tabahi/eBike-Controller/pictures/IMG_20250413_105654676.jpg

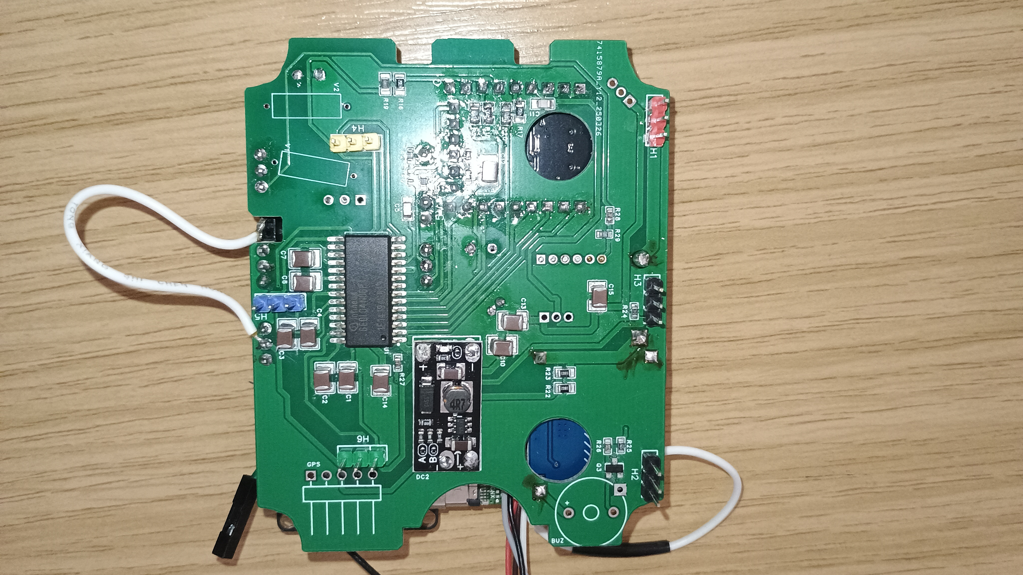
pictures/IMG_20250413_105654676.jpg
