tabahi/eBike-Controller/pictures/IMG_20250413_105704691.jpg

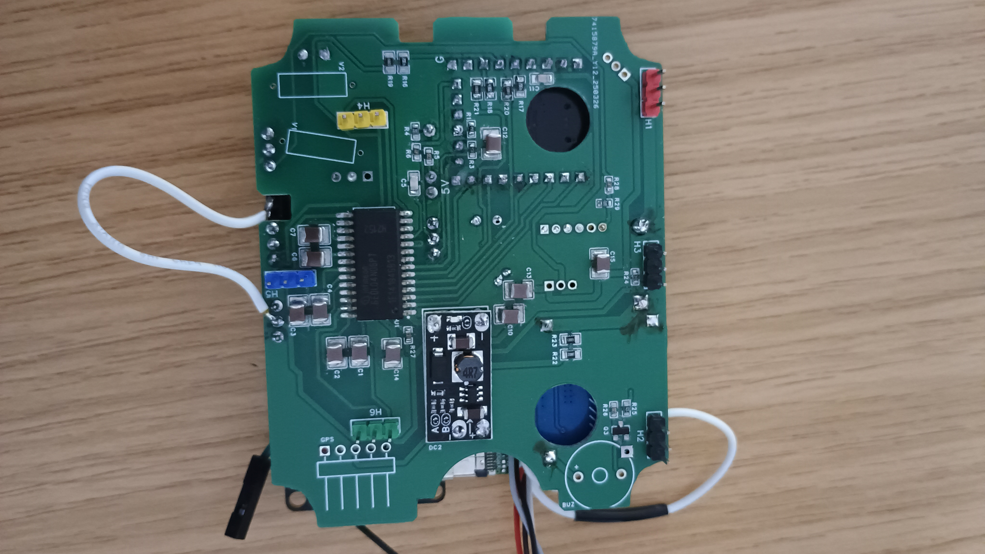
pictures/IMG_20250413_105704691.jpg
