tabahi/eBike-Controller/pictures/IMG_20250413_105737001_HDR.jpg

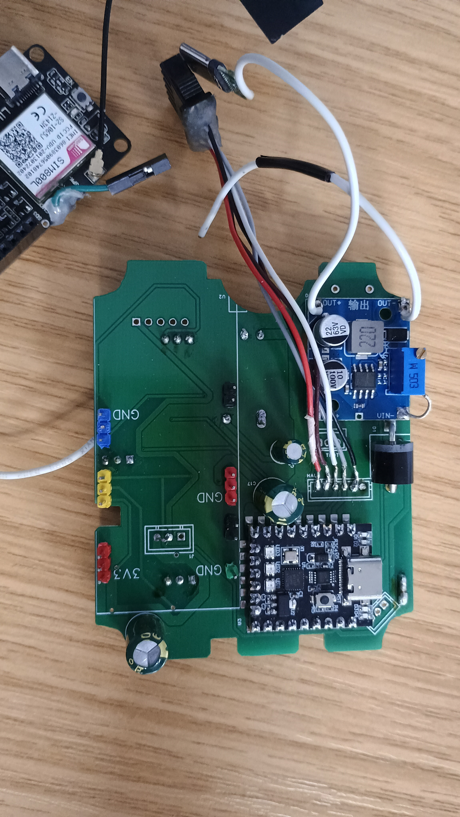
pictures/IMG_20250413_105737001_HDR.jpg
