tabahi/eBike-Controller/pictures/IMG_20250413_105749587.jpg

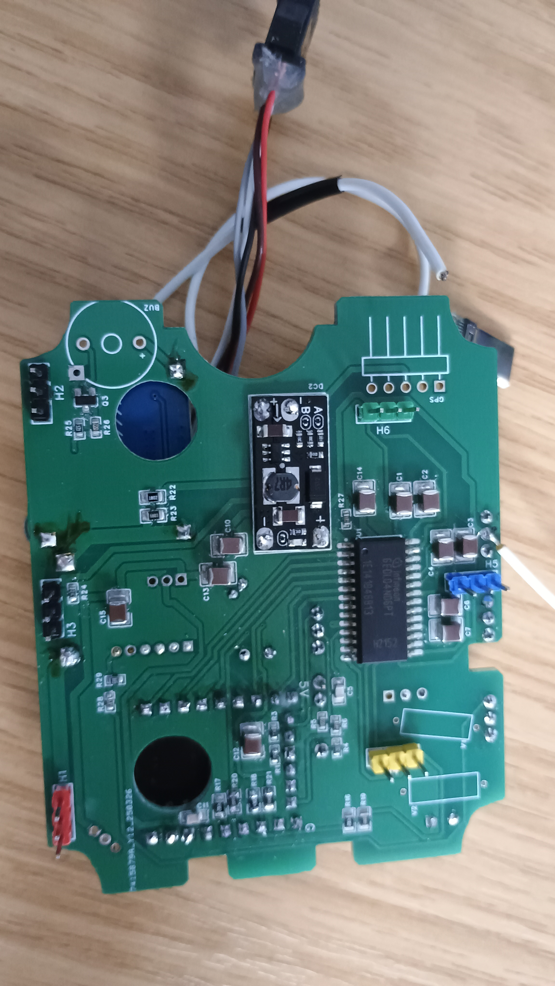
pictures/IMG_20250413_105749587.jpg
