tabahi/eBike-Controller/pictures/IMG_20250413_105753850.jpg

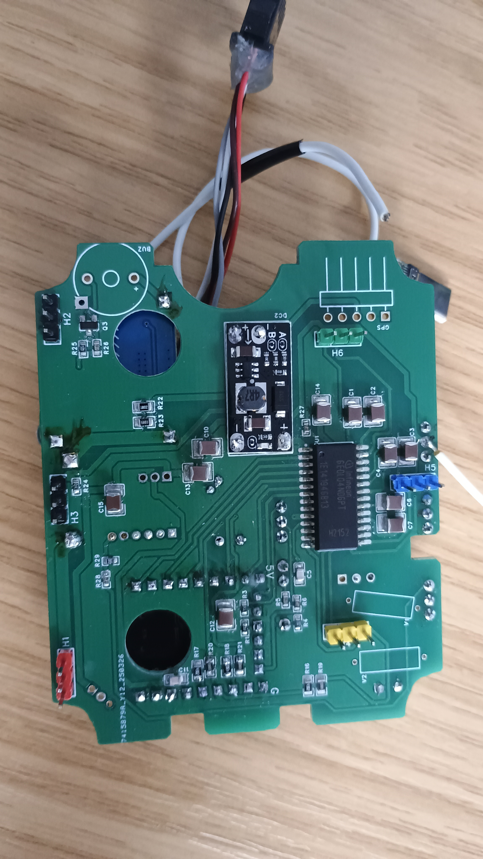
pictures/IMG_20250413_105753850.jpg
