tabahi/eBike-Controller/pictures/IMG_20250518_181155994_HDR.jpg

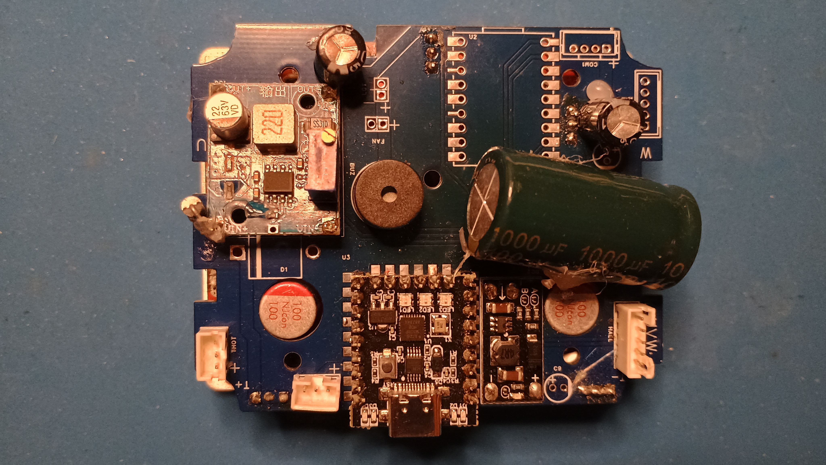
pictures/IMG_20250518_181155994_HDR.jpg
