tabahi/eBike-Controller/pictures/IMG_20250518_181207546_HDR.jpg

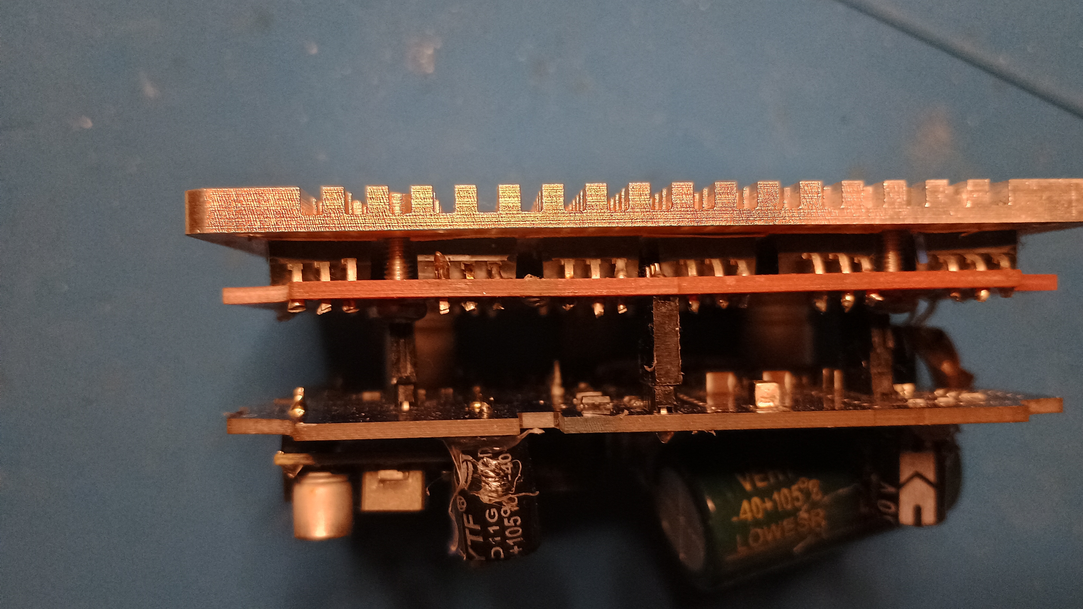
pictures/IMG_20250518_181207546_HDR.jpg
