tabahi/eBike-Controller/PCB_files/Schematic_mosfets_drive_uC_2025-11-24.pdf

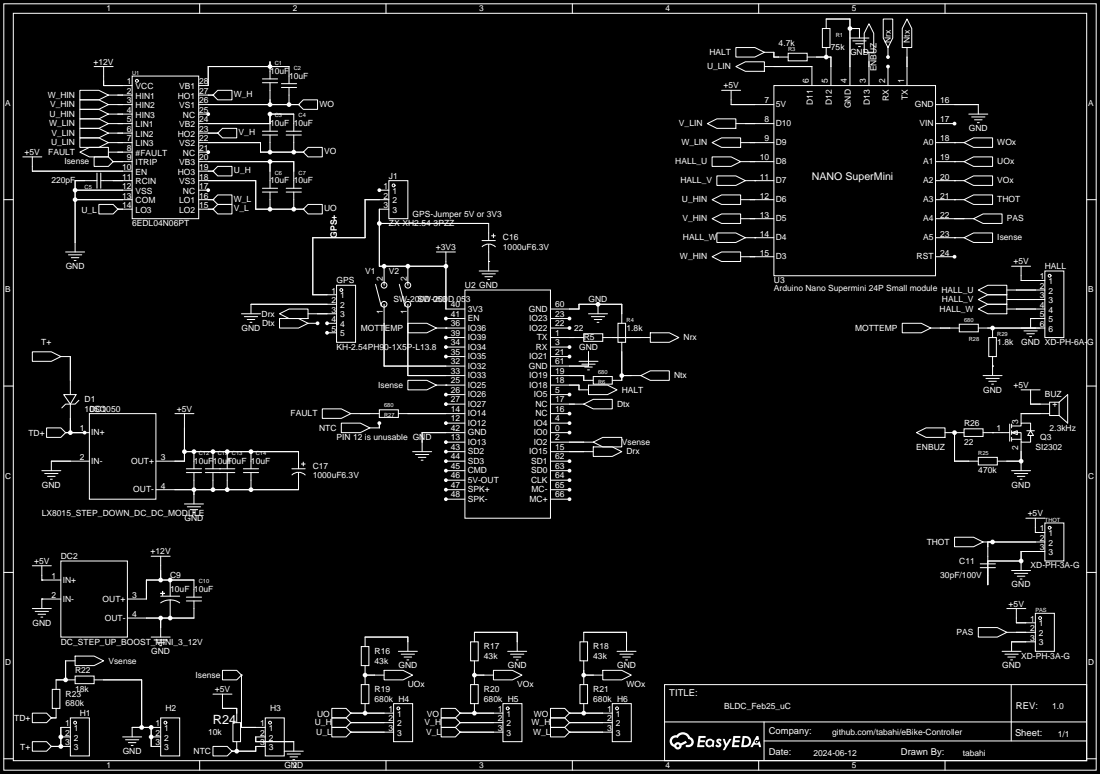
[picture p14: page 1]

Arduino Nano Supermini 24P Small module

github.com/tabahi/eBike-Controller
