tabahi/eBike-Controller/(list of files, drawings)

Other design files:
ProteusSimulations/Arduino Nano.pdsprj
ProteusSimulations/TestMOSFETS.pdsprj
